giulio908/AI_BIN/MGLM_V1/MGLM_V1.ioc

Mcu.UserName=STM32F303VCTx
PA13.Signal=SYS_JTMS-SWDIO
PA14.Signal=SYS_JTCK-SWCLK
PA15.Signal=I2C1_SCL
PA8.Signal=S_TIM1_CH1
PA9.GPIO_Label=ECHOPIN
PA9.Signal=GPXTI9
PB10.GPIO_Label=REQ
PB10.Signal=GPIO_Output
PB11.GPIO_Label=bit0
PB11.Signal=GPIO_Input
PB12.GPIO_Label=bit1
PB12.Signal=GPIO_Input
PB13.GPIO_Label=bit2
PB13.Signal=GPIO_Input
PB14.GPIO_Label=ACK
PB14.Signal=GPXTI14
PB7.Signal=I2C1_SDA
PC4.Signal=USART1_TX
PC5.Signal=USART1_RX
PC9.GPIO_Label=TRIGGERPIN
PC9.Signal=GPIO_Output
PE11.Signal=S_TIM1_CH2
PE13.Signal=S_TIM1_CH3
PF0-OSC_IN.Signal=RCC_OSC_IN
