giulio908/AI_BIN/MGLM_V1/Core/Inc/main.h

#define REQ_Pin GPIO_PIN_10
#define REQ_GPIO_Port GPIOB
#define bit0_Pin GPIO_PIN_11
#define bit0_GPIO_Port GPIOB
#define bit1_Pin GPIO_PIN_12
#define bit1_GPIO_Port GPIOB
#define bit2_Pin GPIO_PIN_13
#define bit2_GPIO_Port GPIOB
#define ACK_Pin GPIO_PIN_14
#define ACK_GPIO_Port GPIOB
#define ACK_EXTI_IRQn EXTI15_10_IRQn
#define TRIGGERPIN_Pin GPIO_PIN_9
#define TRIGGERPIN_GPIO_Port GPIOC
#define ECHOPIN_Pin GPIO_PIN_9
#define ECHOPIN_GPIO_Port GPIOA
#define ECHOPIN_EXTI_IRQn EXTI9_5_IRQn
